Klaus-Kupferschmid/amigahid-pico/kicad/Amiga-HID_rev1.1/Unterseite.stl

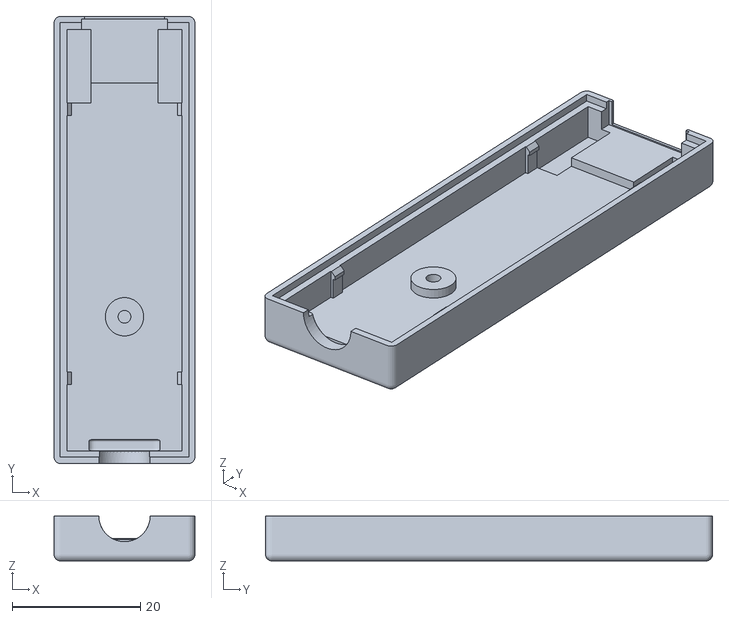
[picture p1: CAD file, 2026-07-23]
kicad/Amiga-HID_rev1.1/Unterseite.stl
22.0 x 69.8 x 7.00
