Klaus-Kupferschmid/amigahid-pico/kicad/Amiga-HID_rev1.1/Oberseite.stl

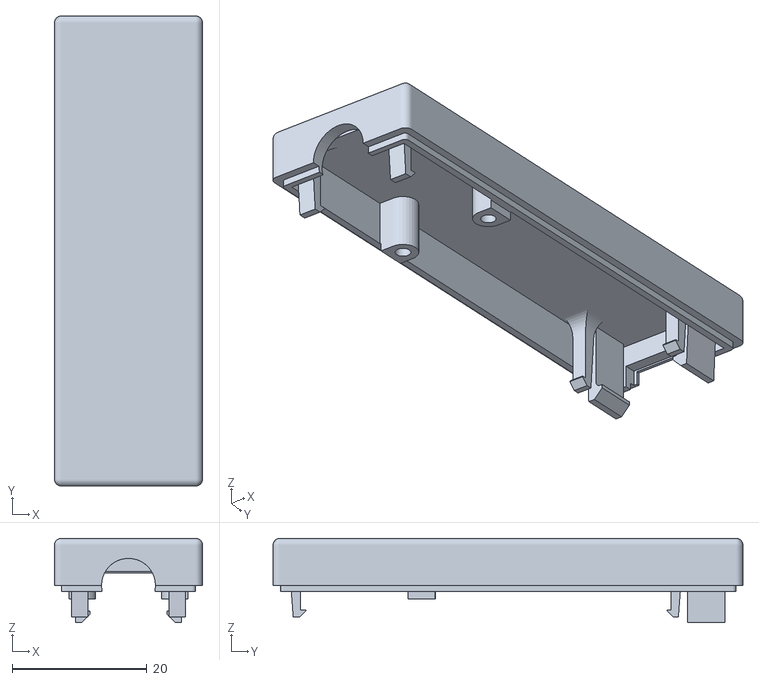
[picture p2: CAD file, 2026-07-23]
kicad/Amiga-HID_rev1.1/Oberseite.stl
22.0 x 69.8 x 12.5
