Klaus-Kupferschmid/amigahid-pico/kicad/Amiga-HID_rev1.1/JST_XH_S5B-XH-A-2_1x05_P2.50mm_Horizontal.step

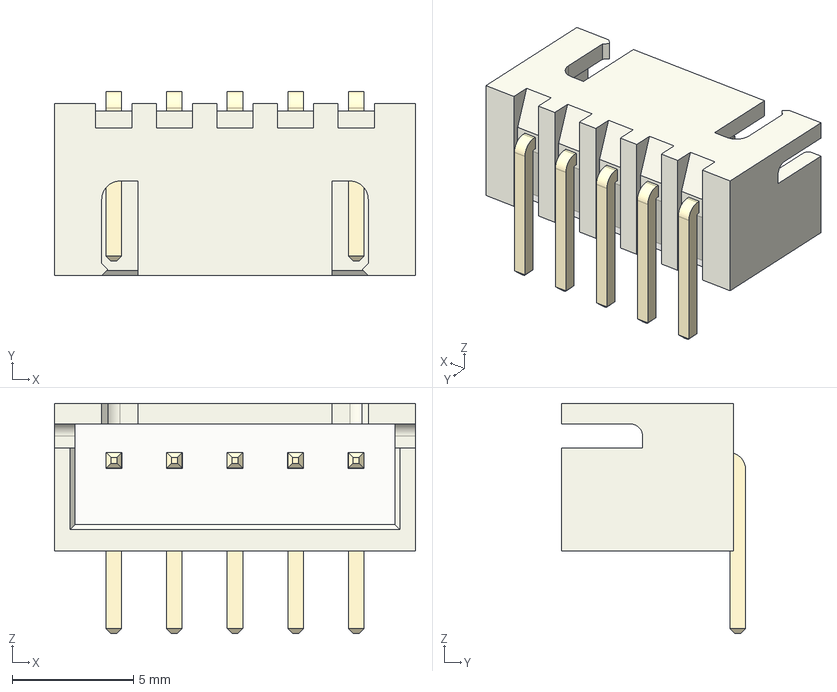
[picture p3: CAD file, 2026-06-02]
kicad/Amiga-HID_rev1.1/JST_XH_S5B-XH-A-2_1x05_P2.50mm_Horizontal.step
14.9 x 7.60 x 9.50 mm
