Klaus-Kupferschmid/amigahid-pico/kicad/Amiga-HID_rev1.1/Amiga-HID_rev1.1.step

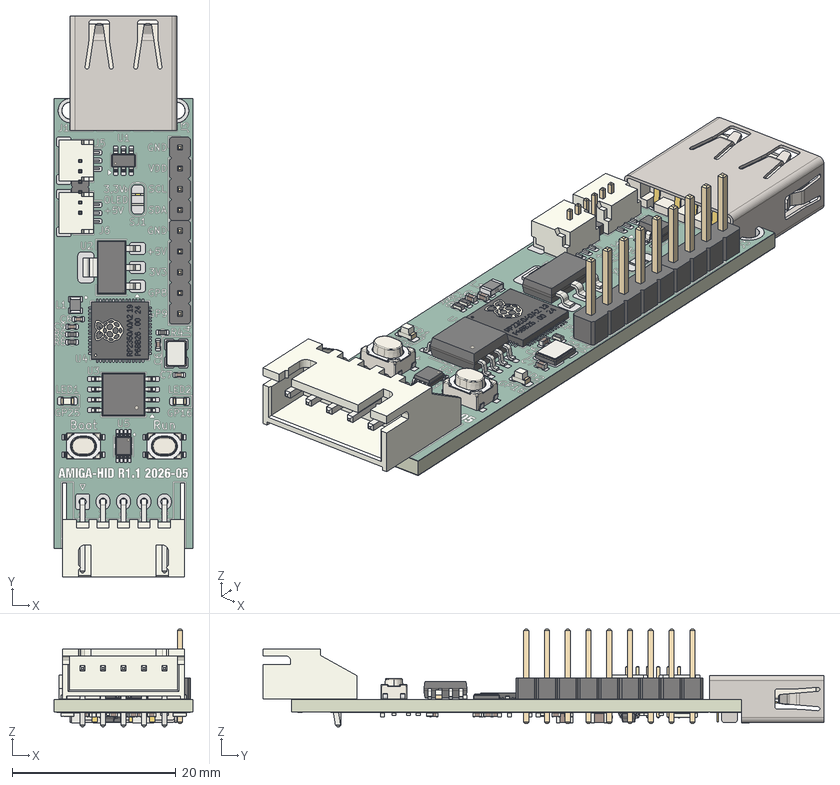
[picture p4: CAD file, 2026-06-02]
kicad/Amiga-HID_rev1.1/Amiga-HID_rev1.1.step
17.0 x 68.6 x 11.9 mm
C139797_TactSwitch_4x3 x 2
PinHeader_1x05_P2.54mm_Vertical
VSSOP-8_2.3x2mm_P0.5mm
C_0402_1005Metric x 21
R_0402_1005Metric x 11
LED_0603_1608Metric x 2
Scale
ShapeString001
ShapeString
SOT-23-6
C1046_Sunlord_L_0805_2u2
SOT-223
JST_SH_SM03B-SRSS-TB_1x03-1MP_P1.00mm_Horizontal x 2
PinHeader_1x06_P1.27mm_Vertical
SOIC-8_5.3x5.3mm_P1.27mm
JST_XH_S5B-XH-A_1x05_P2.50mm_Horizontal
PinHeader_1x04_P2.54mm_Vertical
C42614_USB-A-TH_JTJ
Crystal_SMD_3225-4Pin_3.2x2.5mm
R_0603_1608Metric x 2
D_SOD-323 x 3
C_0805_2012Metric x 2
Fuse_1206_3216Metric
Amiga-HID_rev1.1_copper
Amiga-HID_rev1.1_pad
Amiga-HID_rev1.1_via
Amiga-HID_rev1.1_silkscreen x 2
Amiga-HID_rev1.1_soldermask x 2
Amiga-HID_rev1.1_PCB
