Klaus-Kupferschmid/amigahid-pico/kicad/Amiga-HID_rev1.1/Kabeltülle.stl

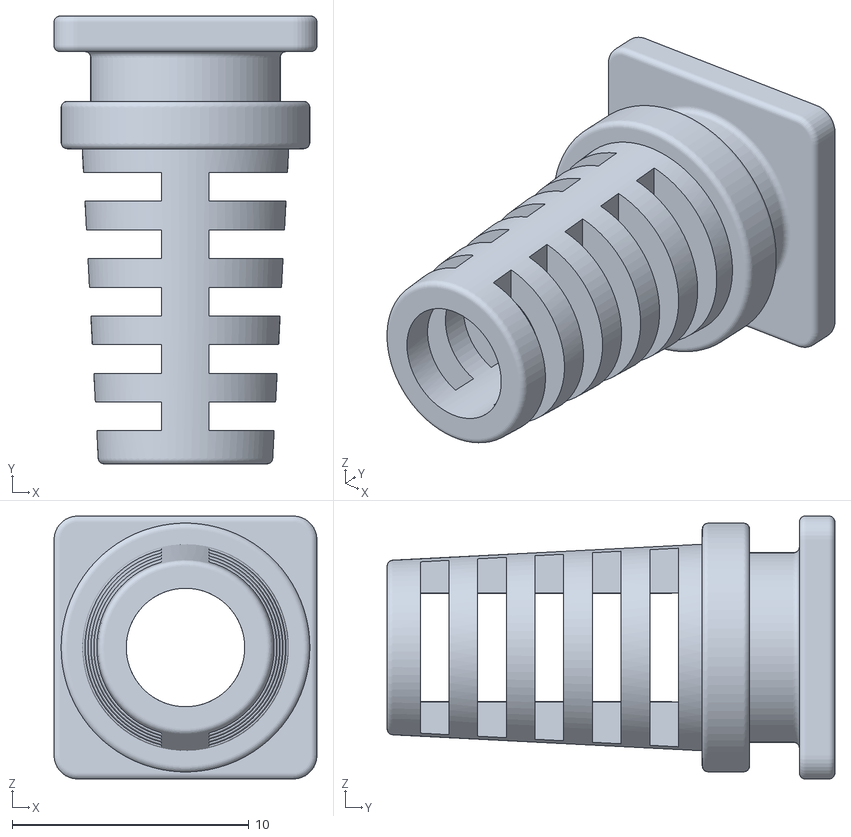
[picture p5: CAD file, 2026-06-02]
kicad/Amiga-HID_rev1.1/Kabeltülle.stl
11.1 x 18.9 x 11.1
