Klaus-Kupferschmid/amigahid-pico/kicad/Amiga-HID_rev1.1/QFN-60_EP3.5_7x7_P0.4mm_RP2350A.step

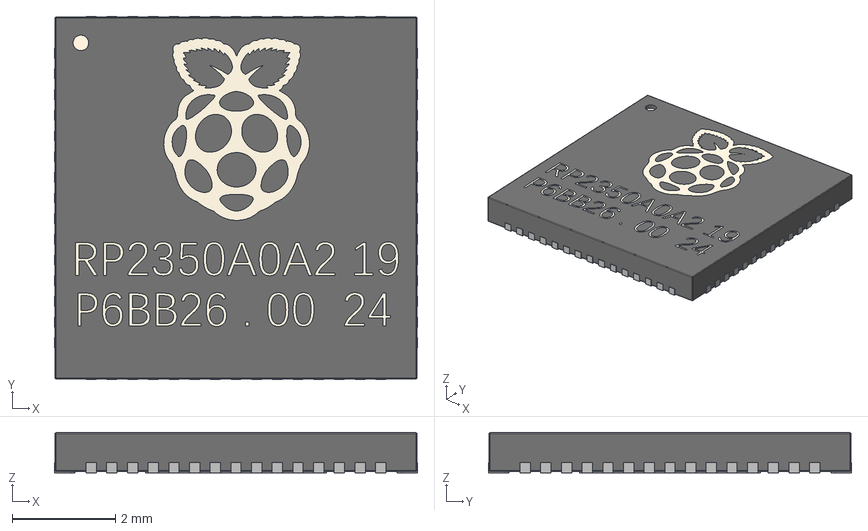
[picture p6: CAD file, 2026-05-04]
kicad/Amiga-HID_rev1.1/QFN-60_EP3.5_7x7_P0.4mm_RP2350A.step
7.02 x 7.02 x 0.785 mm
Scale
ShapeString001
ShapeString
