Klaus-Kupferschmid/amigahid-pico/kicad/Amiga-HID_rev1.1/CONN-SMD_SR1.00-WS-3P.step

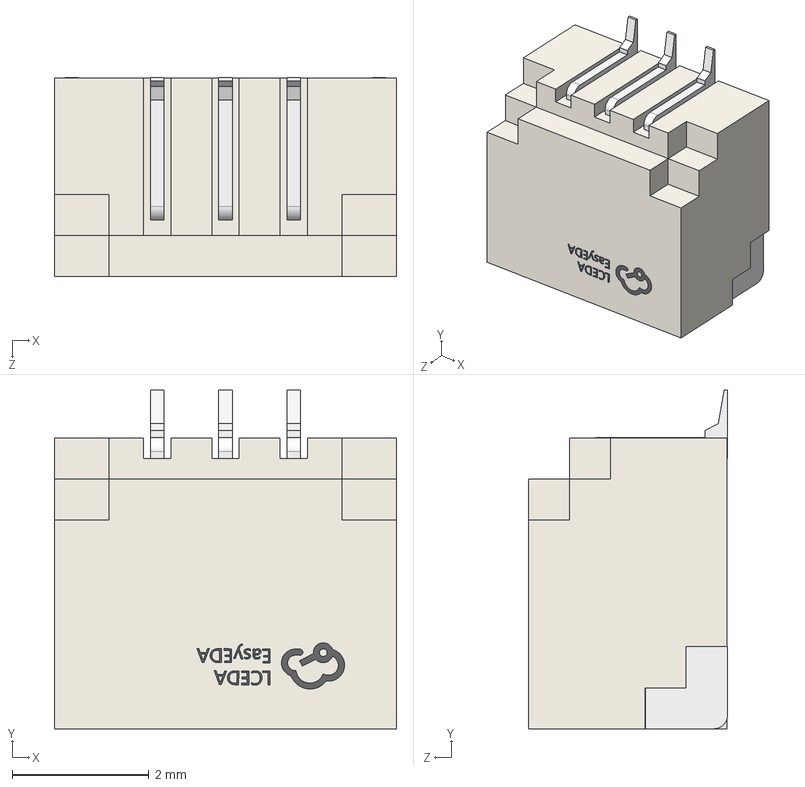
[picture p7: CAD file, 2026-05-03]
kicad/Amiga-HID_rev1.1/CONN-SMD_SR1.00-WS-3P.step
5.00 x 4.95 x 2.91 mm
