Klaus-Kupferschmid/amigahid-pico/kicad/Amiga-HID_rev1.1/C1046_Sunlord_L_0805_2u2.step

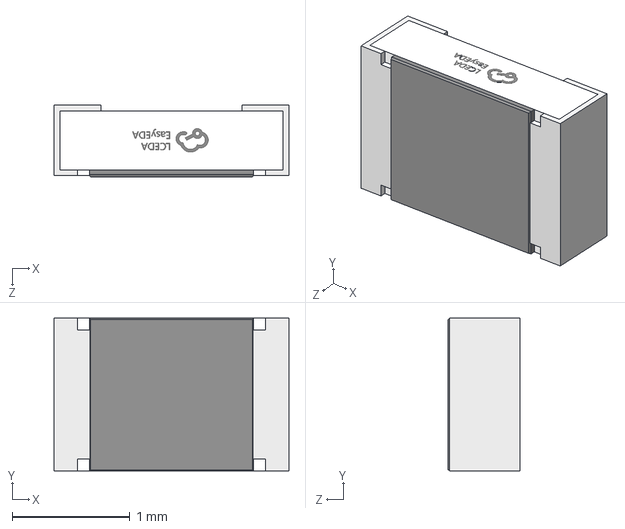
[picture p8: CAD file, 2026-05-03]
kicad/Amiga-HID_rev1.1/C1046_Sunlord_L_0805_2u2.step
2.00 x 1.30 x 0.61 mm
