Klaus-Kupferschmid/amigahid-pico/kicad/Amiga-HID_rev1.1/USB-A-TH_4P-L13.1-W14.1-H5.7-S1.45.step

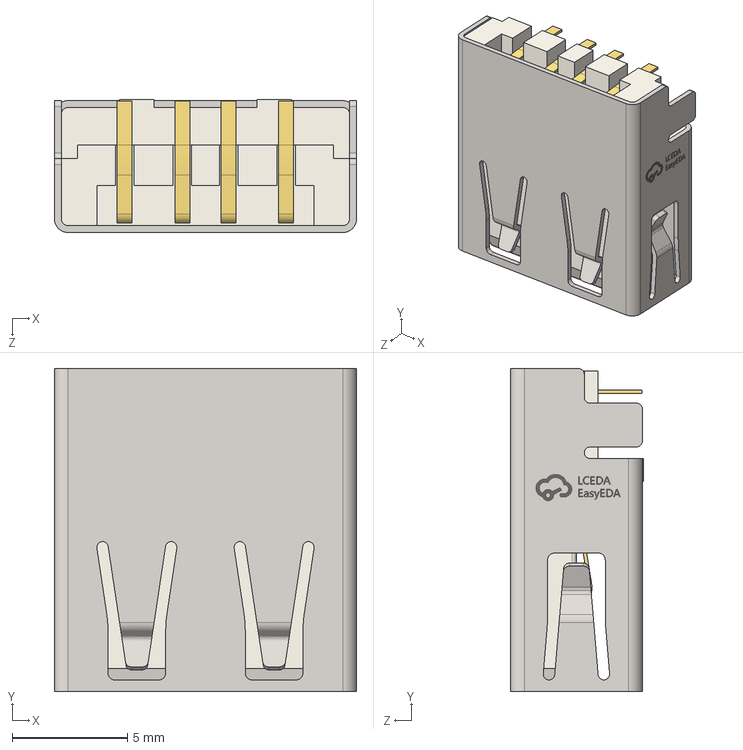
[picture p9: CAD file, 2026-05-03]
kicad/Amiga-HID_rev1.1/USB-A-TH_4P-L13.1-W14.1-H5.7-S1.45.step
13.1 x 14.0 x 5.77 mm
