Klaus-Kupferschmid/amigahid-pico/kicad/Amiga-HID_rev1.1/RP2350_QFN60.step

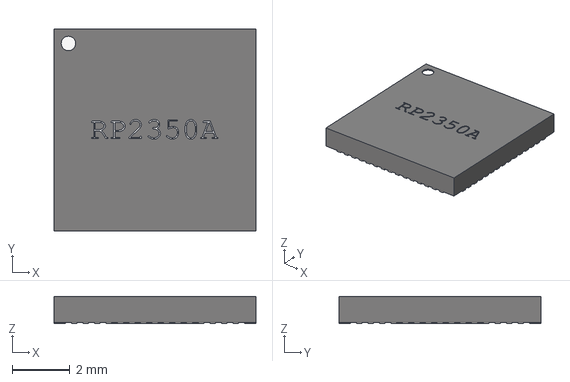
[picture p10: CAD file, 2026-05-02]
kicad/Amiga-HID_rev1.1/RP2350_QFN60.step
7.00 x 7.00 x 0.95 mm
