Klaus-Kupferschmid/amigahid-pico/kicad/Amiga-HID_rev1.1/C139797_TactSwitch_4x3.step

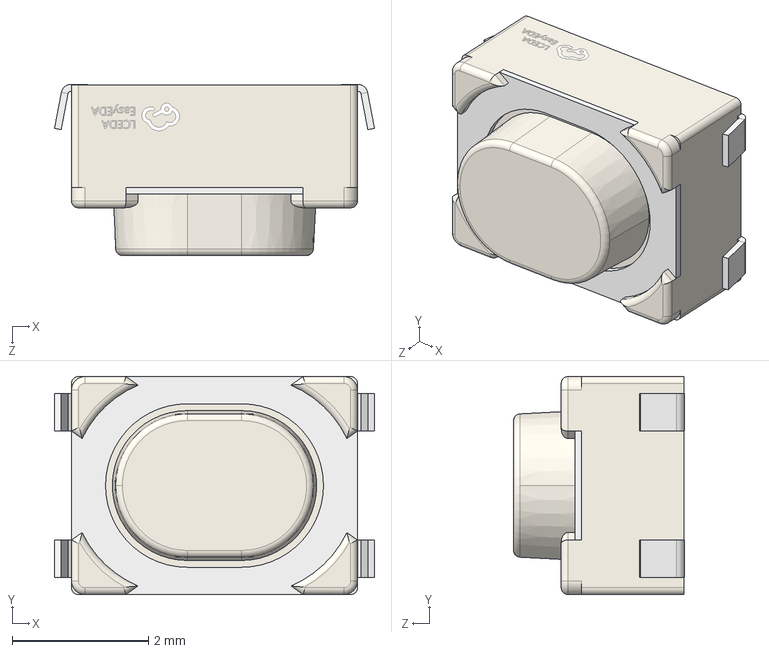
[picture p11: CAD file, 2026-05-03]
kicad/Amiga-HID_rev1.1/C139797_TactSwitch_4x3.step
4.70 x 3.20 x 2.51 mm
