Klaus-Kupferschmid/amigahid-pico/(list of files, cad)

Other CAD files:
kicad/Amiga-HID_rev1.1/JST_XH_S5B-XH-A-1_1x05_P2.50mm_Horizontal.stl
kicad/Amiga-HID_rev1.1/S5B-XH-A.stl
