Klaus-Kupferschmid/amigahid-pico/kicad/Amiga-HID_rev1.1/USB_A_Receptacle_Edge_C42614.pdf

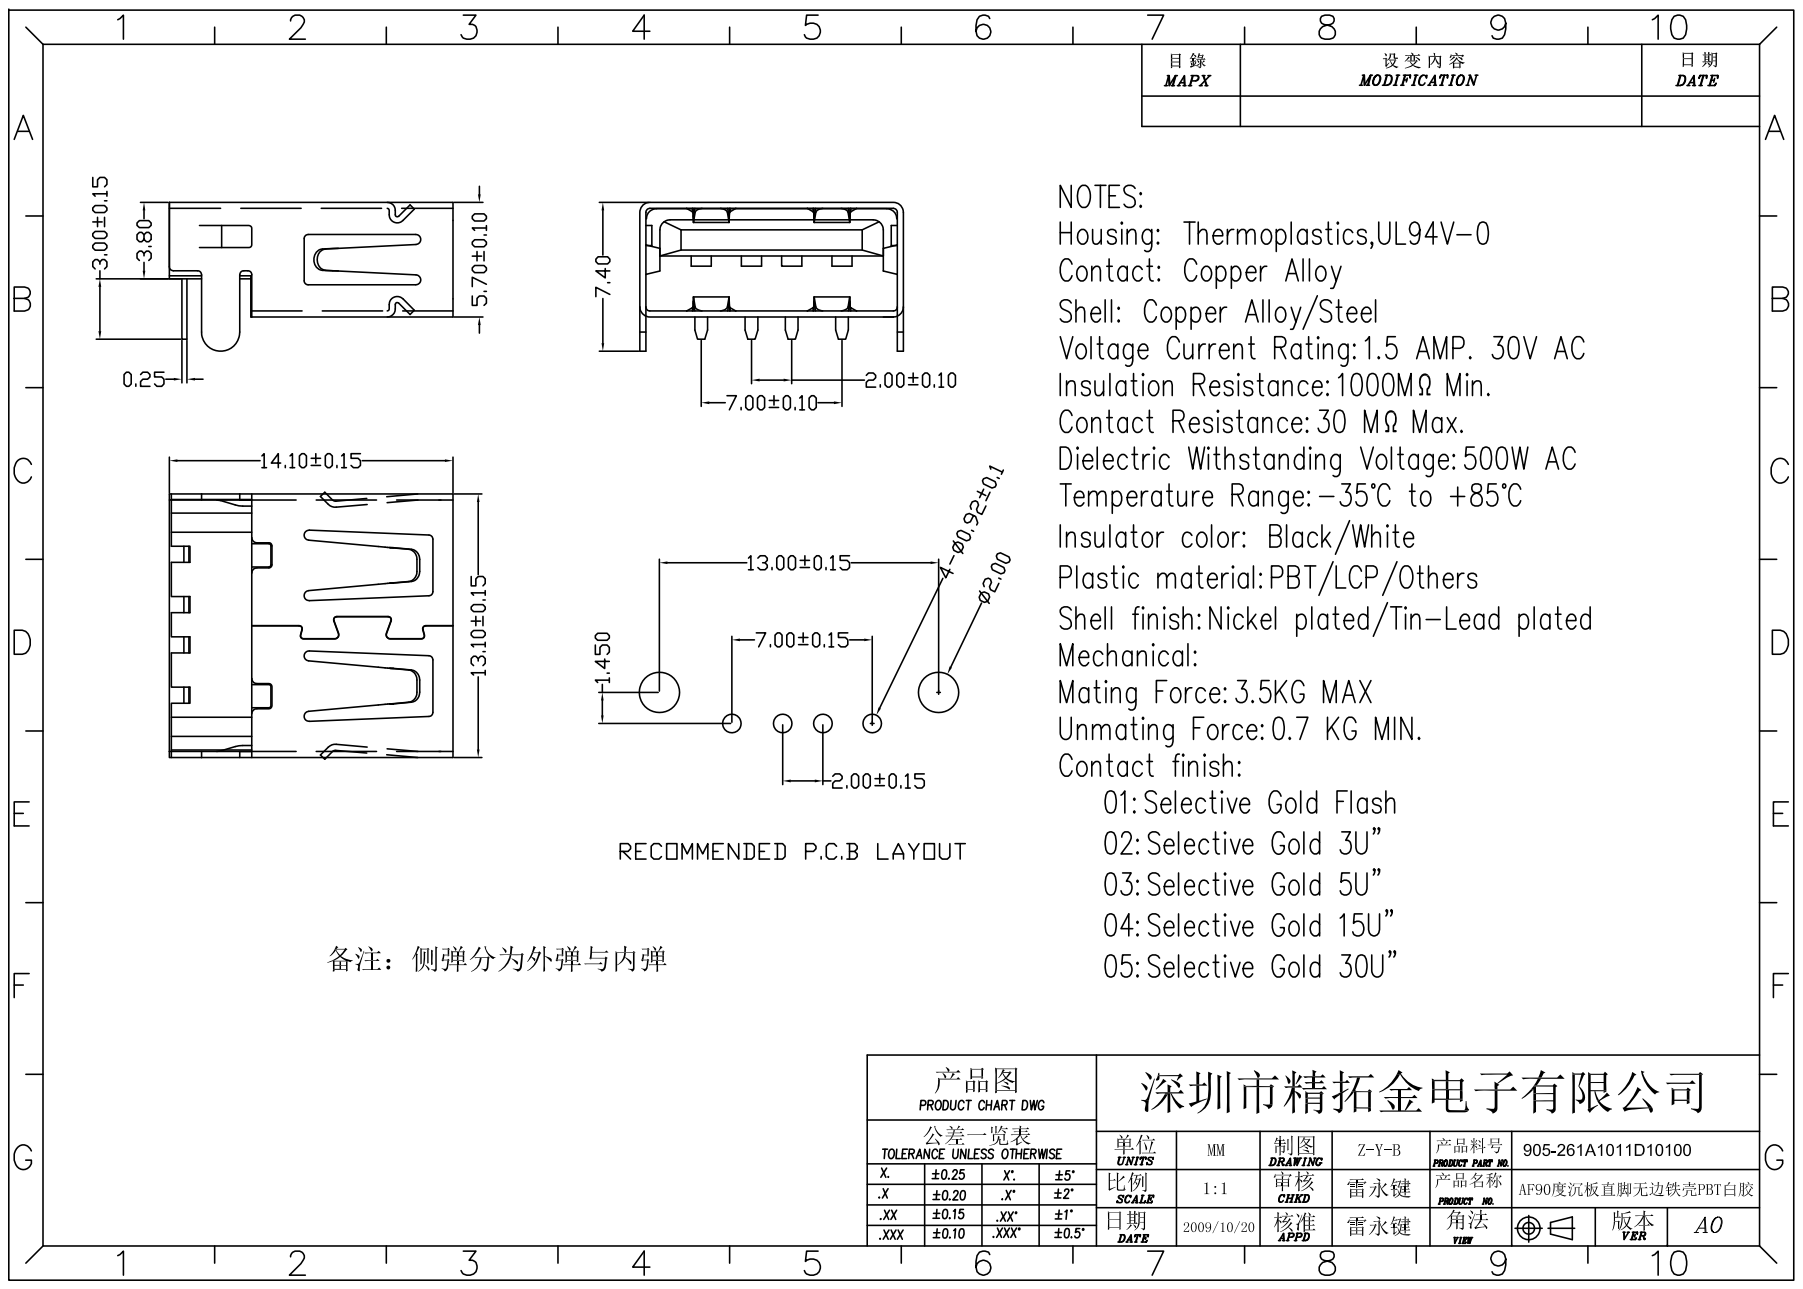
[picture p12: page 1]
