Klaus-Kupferschmid/amigahid-pico/kicad/Amiga-HID_rev1.1/Amiga-HID_rev1.1.kicad_pcb

## KiCad design kicad/Amiga-HID_rev1.1/Amiga-HID_rev1.1.kicad_pcb (2026-07-02)

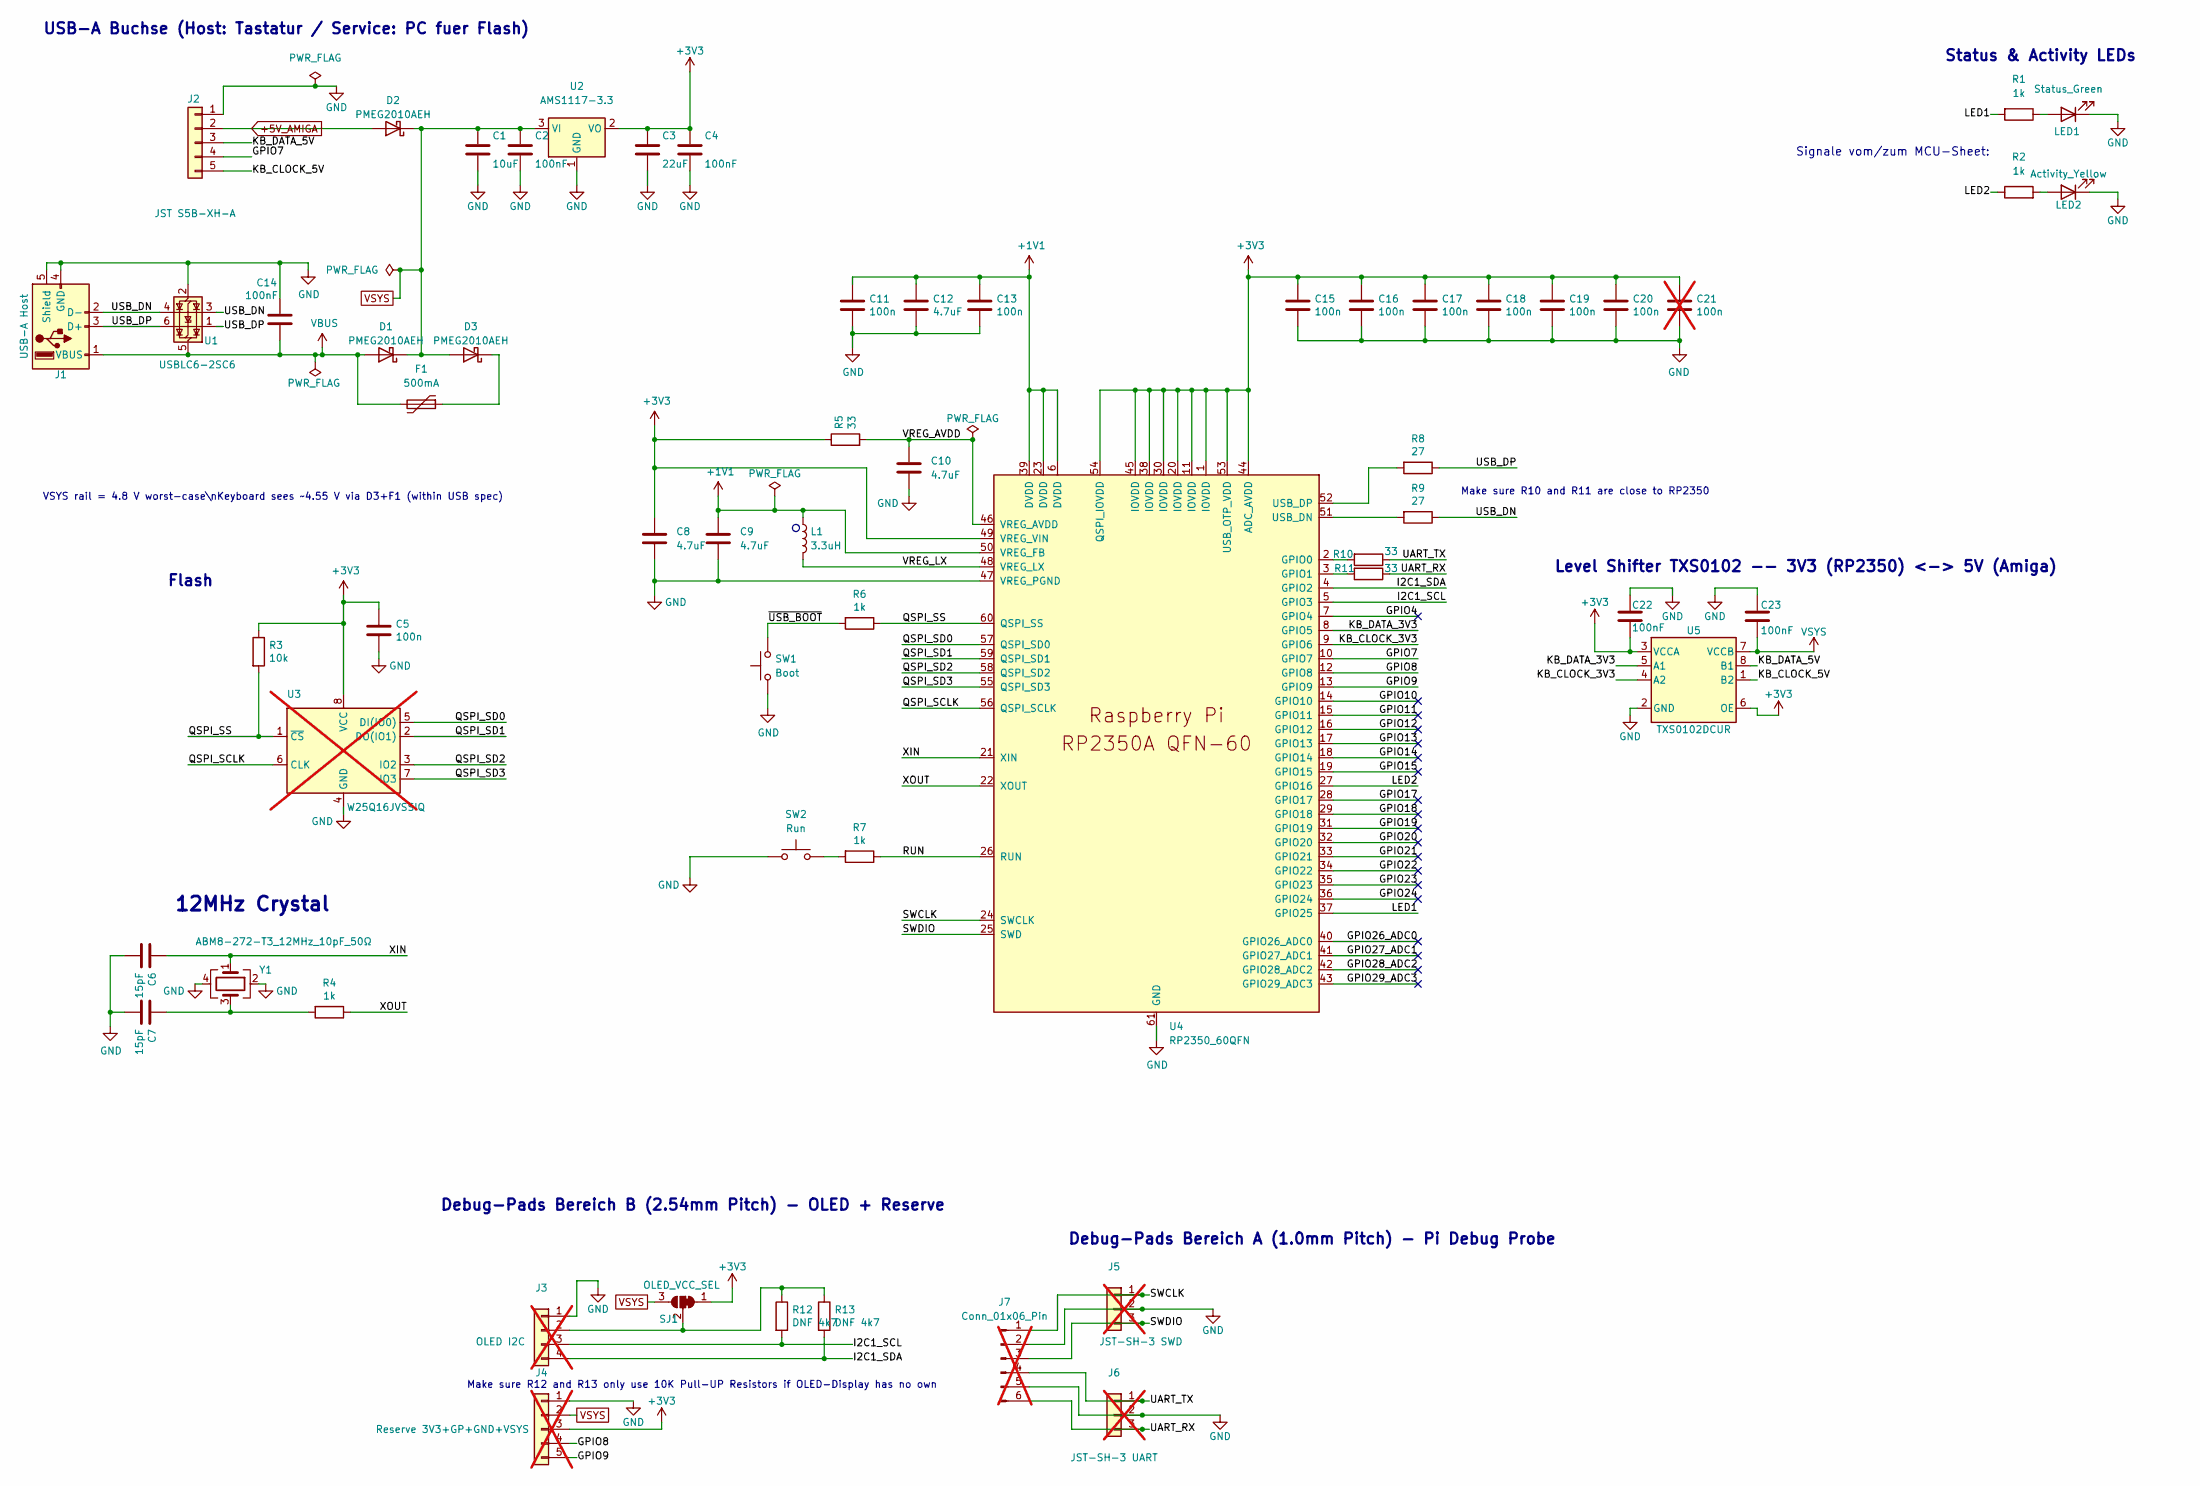
[picture p13: schematic Amiga-HID_rev1.1.kicad_sch, Amiga-HID rev1.1]

Parts:
C1: 10uF; C_0805_2012Metric; LCSC C15850
C2, C14, C22, C23: 100nF; C_0402_1005Metric; LCSC C161530
C3: 22uF; C_0805_2012Metric; LCSC C45783
C4: 100nF; C_0402_1005Metric; LCSC C1525
C5: 100n; C_0402_1005Metric; LCSC C1525
C6, C7: 15pF; C_0402_1005Metric; LCSC C18164617
C8, C9, C10, C12: 4.7uF; C_0402_1005Metric; LCSC C368809
C11, C13, C15, C16, C17, C18, C19, C20: 100n; C_0402_1005Metric; LCSC C161530
C21: 100n; C_0402_1005Metric; LCSC C161530; not fitted
D1, D2, D3: PMEG2010AEH; D_SOD-323; LCSC C53114226
F1: 500mA; Fuse_1206_3216Metric; LCSC C7202014
J1: USB-A Host; USB_A_Receptacle_Edge_C42614; LCSC C42614
J2: JST S5B-XH-A; S5B-XH-A; LCSC C42422447
J3: OLED I2C; PinHeader_1x04_P2.54mm_Vertical; LCSC C52016392; not fitted
J4: Reserve 3V3+GP+GND+VSYS; PinHeader_1x05_P2.54mm_Vertical; LCSC C225480; not fitted
J5: JST-SH-3 SWD; JST_SH_SM03B-SRSS-TB_1x03-1MP_P1.00mm_Horizontal; LCSC C160403; not fitted
J6: JST-SH-3 UART; JST_SH_SM03B-SRSS-TB_1x03-1MP_P1.00mm_Horizontal; LCSC C160403; not fitted
J7: Conn_01x06_Pin; PinHeader_1x06_P1.27mm_Vertical; LCSC C5372829; not fitted
L1: 3.3uH; L_pol_2016; MPN MWSA201610H2R2MT; LCSC C42411119
LED1: Status_Green; LED_0603_1608Metric; LCSC C965804
LED2: Activity_Yellow; LED_0603_1608Metric; LCSC C72038
R1, R2: 1k; R_0603_1608Metric; LCSC C21190
R3: 10k; R_0402_1005Metric; LCSC C25744
R4, R6, R7: 1k; R_0402_1005Metric; LCSC C11702
R5, R10, R11: 33; R_0402_1005Metric; LCSC C25105
R8, R9: 27; R_0402_1005Metric; LCSC C25100
R12, R13: DNF 4k7; R_0402_1005Metric; LCSC C25900
SJ1: OLED_VCC_SEL; SolderJumper-3_P1.3mm_Bridged12_RoundedPad1.0x1.5mm
SW1: Boot; SW_Push_1P1T_NO_Vertical_Wuerth_434133025816; LCSC C139797
SW2: Run; SW_Push_1P1T_NO_Vertical_Wuerth_434133025816; LCSC C139797
U1: USBLC6-2SC6; SOT-23-6; LCSC C19170930
U2: AMS1117-3.3; SOT-223-3_TabPin2; LCSC C2688239
U3: W25Q16JVSSIQ; SOIC-8_5.3x5.3mm_P1.27mm; LCSC C82317; not fitted
U4: RP2350_60QFN; RP2350-QFN-60-1EP_7x7_P0.4mm_EP3.4x3.4mm_ThermalVias; LCSC C41378174
U5: TXS0102DCUR; VSSOP-8_2.3x2mm_P0.5mm; LCSC C53434
Y1: ABM8-272-T3_12MHz_10pF_50Ω; Crystal_SMD_3225-4Pin_3.2x2.5mm; LCSC C20625731

Connections:
+1V1: C9.1, C11.1, C12.1, C13.1, L1.1, U4.6 (DVDD), U4.23 (DVDD), U4.39 (DVDD), U4.50 (VREG_FB)
+3V3: C3.1, C4.1, C5.1, C8.1, C15.1, C16.1, C17.1, C18.1, C19.1, C20.1, C21.1, C22.2, J4.3, R3.1, R5.1, SJ1.1 (A), U2.2 (VO), U3.8 (VCC), U4.1 (IOVDD), U4.11 (IOVDD), U4.20 (IOVDD), U4.30 (IOVDD), U4.38 (IOVDD), U4.44 (ADC_AVDD), U4.45 (IOVDD), U4.49 (VREG_VIN), U4.53 (USB_OTP_VDD), U4.54 (QSPI_IOVDD), U5.3 (VCCA), U5.6 (OE)
+5V_AMIGA: D2.2 (A), J2.2
/GPIO4: U4.7 (GPIO4)
/GPIO7: J2.4, U4.10 (GPIO7)
/GPIO8: J4.4, U4.12 (GPIO8)
/GPIO9: J4.5, U4.13 (GPIO9)
/GPIO10: U4.14 (GPIO10)
/GPIO11: U4.15 (GPIO11)
/GPIO12: U4.16 (GPIO12)
/GPIO13: U4.17 (GPIO13)
/GPIO14: U4.18 (GPIO14)
/GPIO15: U4.19 (GPIO15)
/GPIO17: U4.28 (GPIO17)
/GPIO18: U4.29 (GPIO18)
/GPIO19: U4.31 (GPIO19)
/GPIO20: U4.32 (GPIO20)
/GPIO21: U4.33 (GPIO21)
/GPIO22: U4.34 (GPIO22)
/GPIO23: U4.35 (GPIO23)
/GPIO24: U4.36 (GPIO24)
/GPIO26_ADC0: U4.40 (GPIO26_ADC0)
/GPIO27_ADC1: U4.41 (GPIO27_ADC1)
/GPIO28_ADC2: U4.42 (GPIO28_ADC2)
/GPIO29_ADC3: U4.43 (GPIO29_ADC3)
/I2C1_SCL: J3.3, R12.2, U4.5 (GPIO3)
/I2C1_SDA: J3.4, R13.2, U4.4 (GPIO2)
/KB_CLOCK_3V3: U4.9 (GPIO6), U5.4 (A2)
/KB_CLOCK_5V: J2.5, U5.1 (B2)
/KB_DATA_3V3: U4.8 (GPIO5), U5.5 (A1)
/KB_DATA_5V: J2.3, U5.8 (B1)
/LED1: R1.2, U4.37 (GPIO25)
/LED2: R2.1, U4.27 (GPIO16)
/QSPI_SCLK: U3.6 (CLK), U4.56 (QSPI_SCLK)
/QSPI_SD0: U3.5 (DI(IO0)), U4.57 (QSPI_SD0)
/QSPI_SD1: U3.2 (DO(IO1)), U4.59 (QSPI_SD1)
/QSPI_SD2: U3.3 (IO2), U4.58 (QSPI_SD2)
/QSPI_SD3: U3.7 (IO3), U4.55 (QSPI_SD3)
/QSPI_SS: R3.2, R6.1, U3.1 (~CS), U4.60 (QSPI_SS)
/RUN: R7.1, U4.26 (RUN)
/SWCLK: J5.1, J7.1, U4.24 (SWCLK)
/SWDIO: J5.3, J7.3, U4.25 (SWD)
/UART_RX: J6.3, J7.6, R11.1
/UART_TX: J6.1, J7.4, R10.1
/USB_DN: J1.2 (D-), R9.1, U1.3 (I/O2), U1.4 (I/O2)
/USB_DP: J1.3 (D+), R8.1, U1.1 (I/O1), U1.6 (I/O1)
/VREG_AVDD: C10.1, R5.2, U4.46 (VREG_AVDD)
/VREG_LX: L1.2, U4.48 (VREG_LX)
/XIN: C6.1, U4.21 (XIN), Y1.1
/XOUT: R4.1, U4.22 (XOUT)
/~USB_BOOT: R6.2, SW1.2
GND: C1.2, C2.2, C3.2, C4.2, C5.2, C6.2, C7.2, C8.2, C9.2, C10.2, C11.2, C12.2, C13.2, C14.1, C15.2, C16.2, C17.2, C18.2, C19.2, C20.2, C21.2, C22.1, C23.1, J1.4 (GND), J1.5 (Shield), J2.1, J3.1, J4.1, J5.2, J6.2, J7.2, J7.5, LED1.1 (K), LED2.1 (K), SW1.1, SW2.1, U1.2 (GND), U2.1 (GND), U3.4 (GND), U4.47 (VREG_PGND), U4.61 (GND), U5.2 (GND), Y1.2, Y1.4
unnamed: C7.1, R4.2, Y1.3
unnamed: D3.1 (K), F1.1
unnamed: J3.2, R12.1, R13.1, SJ1.2 (C)
unnamed: LED1.2 (A), R1.1
unnamed: LED2.2 (A), R2.2
unnamed: R7.2, SW2.2
unnamed: R10.2, U4.2 (GPIO0)
unnamed: R11.2, U4.3 (GPIO1)
unnamed: R9.2, U4.51 (USB_DN)
unnamed: R8.2, U4.52 (USB_DP)
VBUS: C14.2, D1.2 (A), F1.2, J1.1 (VBUS), U1.5 (VBUS)
VSYS: C1.1, C2.1, C23.2, D1.1 (K), D2.1 (K), D3.2 (A), J4.2, SJ1.3 (B), U2.3 (VI), U5.7 (VCCB)

Notes on the sheet:
USB-A Buchse (Host: Tastatur / Service: PC fuer Flash)
Make sure R12 and R13 only use 10K Pull-UP Resistors if OLED-Display has no own
Signale vom/zum MCU-Sheet:
Status & Activity LEDs
Flash
Debug-Pads Bereich B (2.54mm Pitch) - OLED + Reserve
Make sure R10 and R11 are close to RP2350
Level Shifter TXS0102 -- 3V3 (RP2350) <-> 5V (Amiga)
12MHz Crystal
VSYS rail = 4.8 V worst-case\nKeyboard sees ~4.55 V via D3+F1 (within USB spec)
Debug-Pads Bereich A (1.0mm Pitch) - Pi Debug Probe

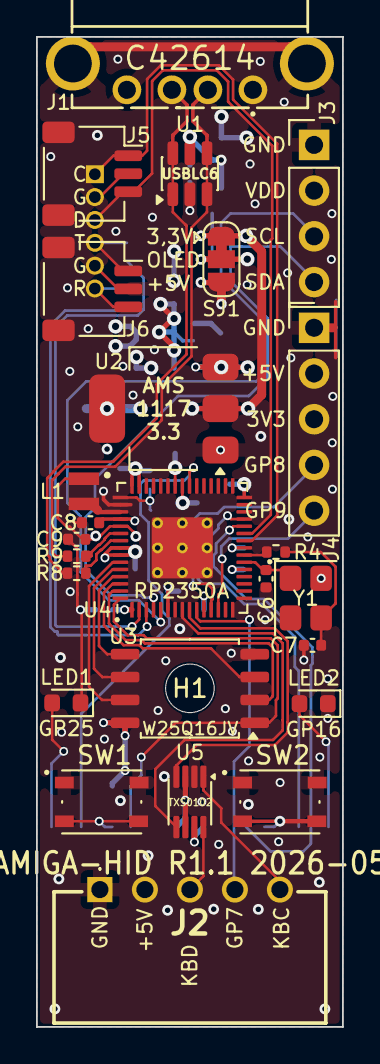
[picture p14: board Amiga-HID_rev1.1.kicad_pcb from above]

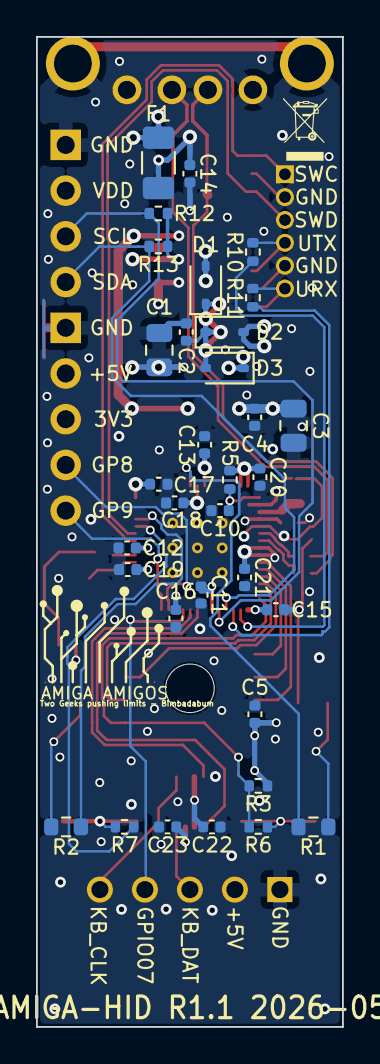
[picture p15: board Amiga-HID_rev1.1.kicad_pcb from below]

Board: 4 copper layers, 17.0 x 55.0 mm, 60 parts (33 on the bottom side), 45 nets.

Other parts of the board:
H1: MountingHole; MountingHole_2.7mm
