Klaus-Kupferschmid/amigahid-pico/kicad/amigahid-pico/amigahid-pico.kicad_pcb

## KiCad design kicad/amigahid-pico/amigahid-pico.kicad_pcb (2026-05-06)

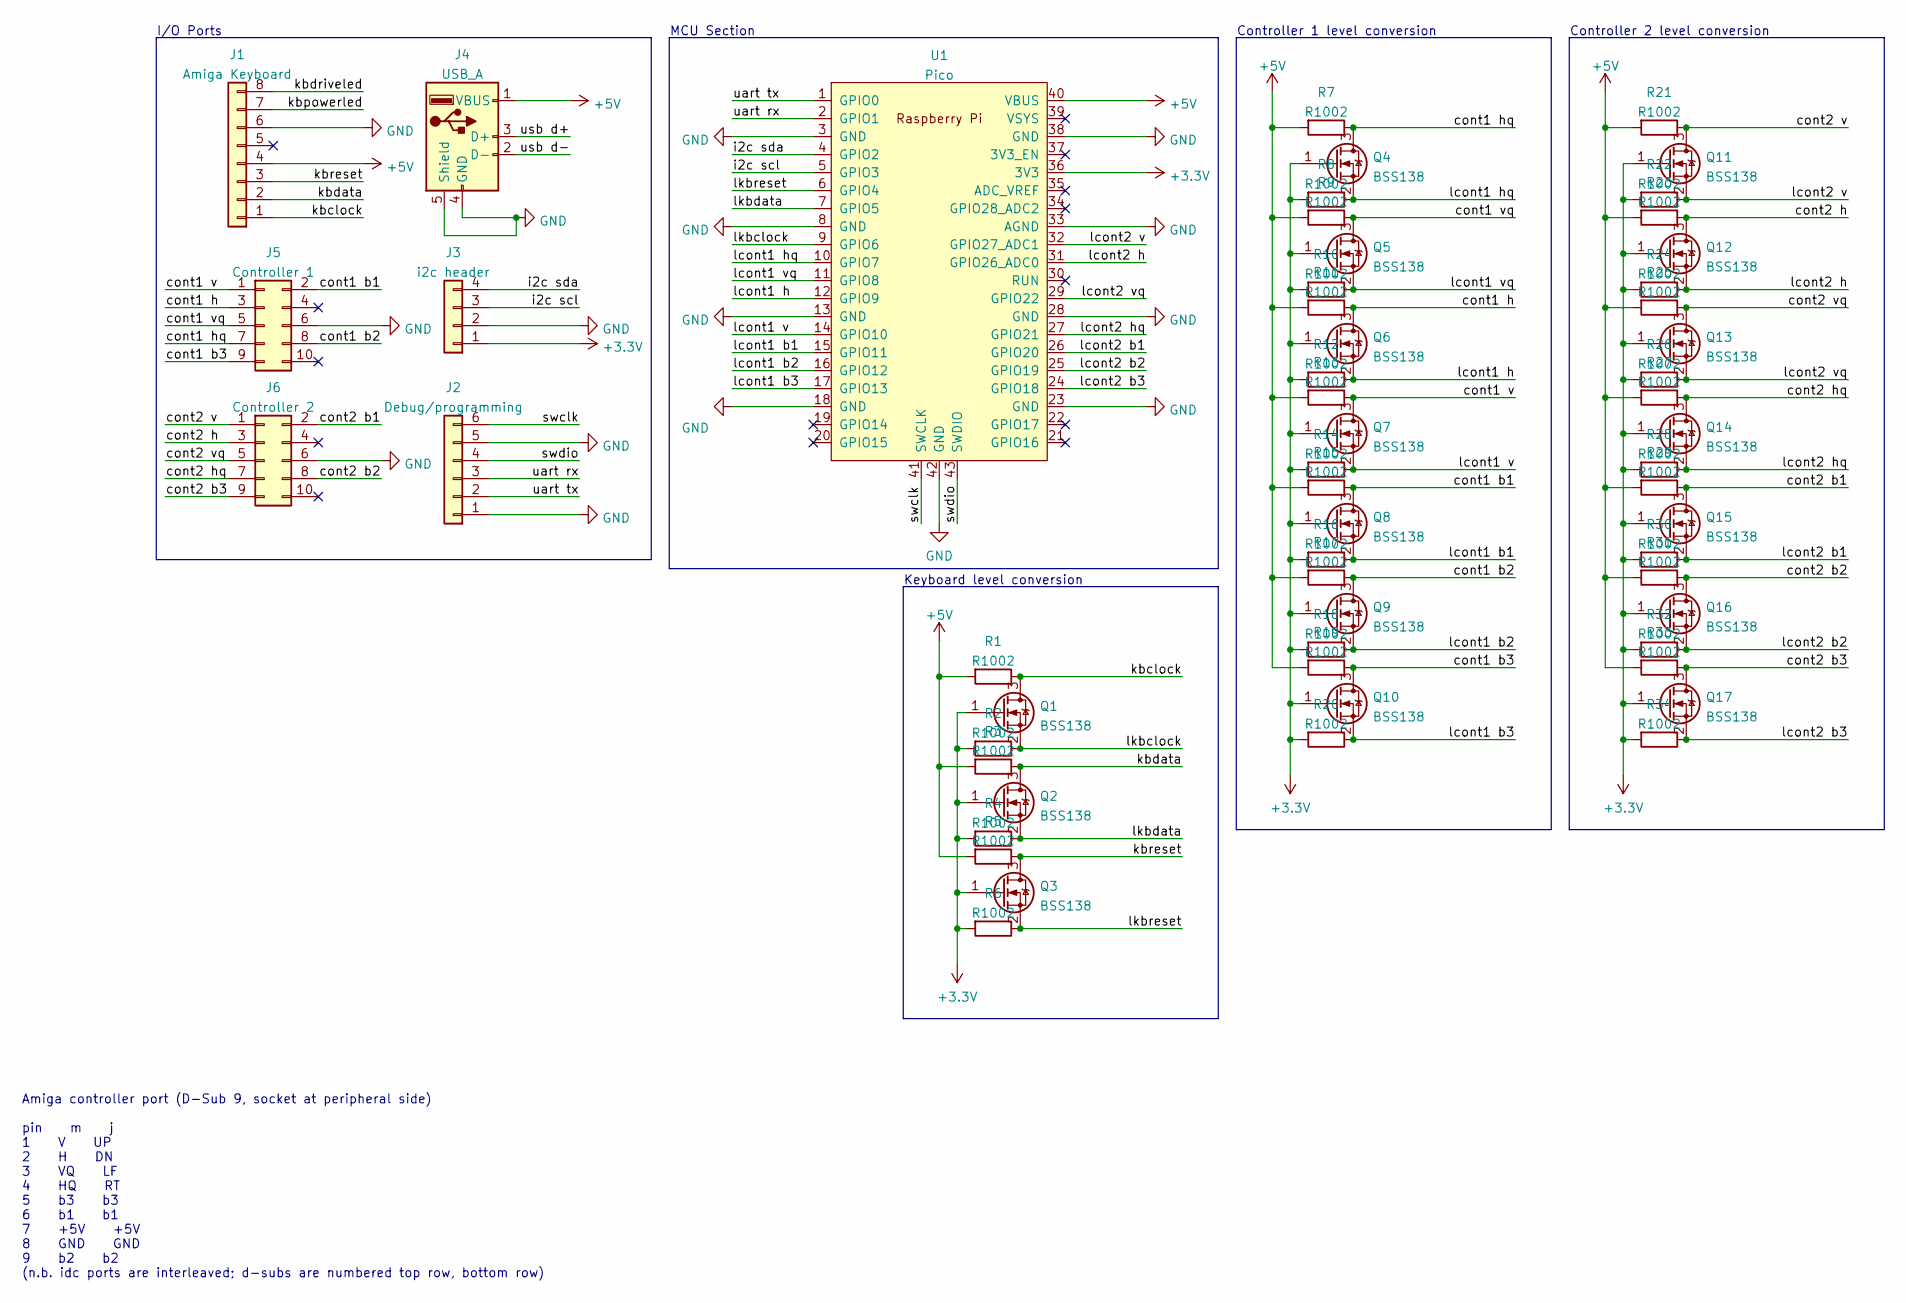
[picture p18: schematic amigahid-pico.kicad_sch, amiga keyboard adapter]

Parts:
J1: Amiga Keyboard; PinHeader_1x08_P2.54mm_Vertical
J2: Debug/programming; PinHeader_1x06_P2.54mm_Horizontal
J3: i2c header; PinHeader_1x04_P2.54mm_Vertical
J4: USB_A; USB_A_Molex_67643_Horizontal
J5: Controller 1; IDC-Header_2x05_P2.54mm_Vertical
J6: Controller 2; IDC-Header_2x05_P2.54mm_Vertical
Q1, Q2, Q3, Q4, Q5, Q6, Q7, Q8, Q9, Q10, Q11, Q12, Q13, Q14, Q15, Q16, Q17: BSS138; SOT-23
R1, R2, R3, R4, R5, R6, R7, R8, R9, R10, R11, R12, R13, R14, R15, R16, R17, R18, R19, R20, R21, R22, R23, R24, R25, R26, R27, R28, R29, R30, R31, R32, R33, R34: R1002; R_0603_1608Metric
U1: Pico; RPi_Pico_SMD_TH

Connections:
+3V3: J3.1, Q1.1 (G), Q2.1 (G), Q3.1 (G), Q4.1 (G), Q5.1 (G), Q6.1 (G), Q7.1 (G), Q8.1 (G), Q9.1 (G), Q10.1 (G), Q11.1 (G), Q12.1 (G), Q13.1 (G), Q14.1 (G), Q15.1 (G), Q16.1 (G), Q17.1 (G), R2.2, R4.2, R6.2, R8.2, R10.2, R12.2, R14.2, R16.2, R18.2, R20.2, R22.2, R24.2, R26.2, R28.2, R30.2, R32.2, R34.2, U1.36 (3V3)
+5V: J1.4, J4.1 (VBUS), R1.2, R3.2, R5.2, R7.2, R9.2, R11.2, R13.2, R15.2, R17.2, R19.2, R21.2, R23.2, R25.2, R27.2, R29.2, R31.2, R33.2, U1.40 (VBUS); also elsewhere on the board
/cont1 b1: J5.2, Q8.3 (D), R15.1; also elsewhere on the board
/cont1 b2: J5.8, Q9.3 (D), R17.1
/cont1 b3: J5.9, Q10.3 (D), R19.1
/cont1 h: J5.3, Q6.3 (D), R11.1
/cont1 hq: J5.7, Q4.3 (D), R7.1
/cont1 v: J5.1, Q7.3 (D), R13.1
/cont1 vq: J5.5, Q5.3 (D), R9.1
/cont2 b1: J6.2, Q15.3 (D), R29.1
/cont2 b2: J6.8, Q16.3 (D), R31.1
/cont2 b3: J6.9, Q17.3 (D), R33.1
/cont2 h: J6.3, Q12.3 (D), R23.1
/cont2 hq: J6.7, Q14.3 (D), R27.1
/cont2 v: J6.1, Q11.3 (D), R21.1
/cont2 vq: J6.5, Q13.3 (D), R25.1
/i2c scl: J3.3, U1.5 (GPIO3)
/i2c sda: J3.4, U1.4 (GPIO2)
/kbclock: J1.1, Q1.3 (D), R1.1
/kbdata: J1.2, Q2.3 (D), R3.1
/kbdriveled: J1.8
/kbpowerled: J1.7
/kbreset: J1.3, Q3.3 (D), R5.1
/lcont1 b1: Q8.2 (S), R16.1, U1.15 (GPIO11)
/lcont1 b2: Q9.2 (S), R18.1, U1.16 (GPIO12)
/lcont1 b3: Q10.2 (S), R20.1, U1.17 (GPIO13)
/lcont1 h: Q6.2 (S), R12.1, U1.12 (GPIO9)
/lcont1 hq: Q4.2 (S), R8.1, U1.10 (GPIO7)
/lcont1 v: Q7.2 (S), R14.1, U1.14 (GPIO10)
/lcont1 vq: Q5.2 (S), R10.1, U1.11 (GPIO8)
/lcont2 b1: Q15.2 (S), R30.1, U1.26 (GPIO20)
/lcont2 b2: Q16.2 (S), R32.1, U1.25 (GPIO19)
/lcont2 b3: Q17.2 (S), R34.1, U1.24 (GPIO18)
/lcont2 h: Q12.2 (S), R24.1, U1.31 (GPIO26_ADC0)
/lcont2 hq: Q14.2 (S), R28.1, U1.27 (GPIO21)
/lcont2 v: Q11.2 (S), R22.1, U1.32 (GPIO27_ADC1)
/lcont2 vq: Q13.2 (S), R26.1, U1.29 (GPIO22)
/lkbclock: Q1.2 (S), R2.1, U1.9 (GPIO6)
/lkbdata: Q2.2 (S), R4.1, U1.7 (GPIO5)
/lkbreset: Q3.2 (S), R6.1, U1.6 (GPIO4)
/swclk: J2.6, U1.41 (SWCLK)
/swdio: J2.4, U1.43 (SWDIO)
/uart rx: J2.3, U1.2 (GPIO1)
/uart tx: J2.2, U1.1 (GPIO0)
/usb d+: J4.3 (D+)
/usb d-: J4.2 (D-)
GND: J1.6, J2.1, J2.5, J3.2, J4.4 (GND), J4.5 (Shield), J5.6, J6.6, U1.3 (GND), U1.8 (GND), U1.13 (GND), U1.18 (GND), U1.23 (GND), U1.28 (GND), U1.33 (AGND), U1.38 (GND), U1.42 (GND)

Notes on the sheet:
Amiga controller port (D-Sub 9, socket at peripheral side) pin m j 1 V UP 2 H DN 3 VQ LF 4 HQ RT 5 b3 b3 6 b1 b1 7 +5V +5V 8 GND GND 9 b2 b2 (n.b. idc ports are interleaved; d-subs are numbered top row, bottom row)
MCU Section
I/O Ports
Controller 1 level conversion
Controller 2 level conversion
Keyboard level conversion

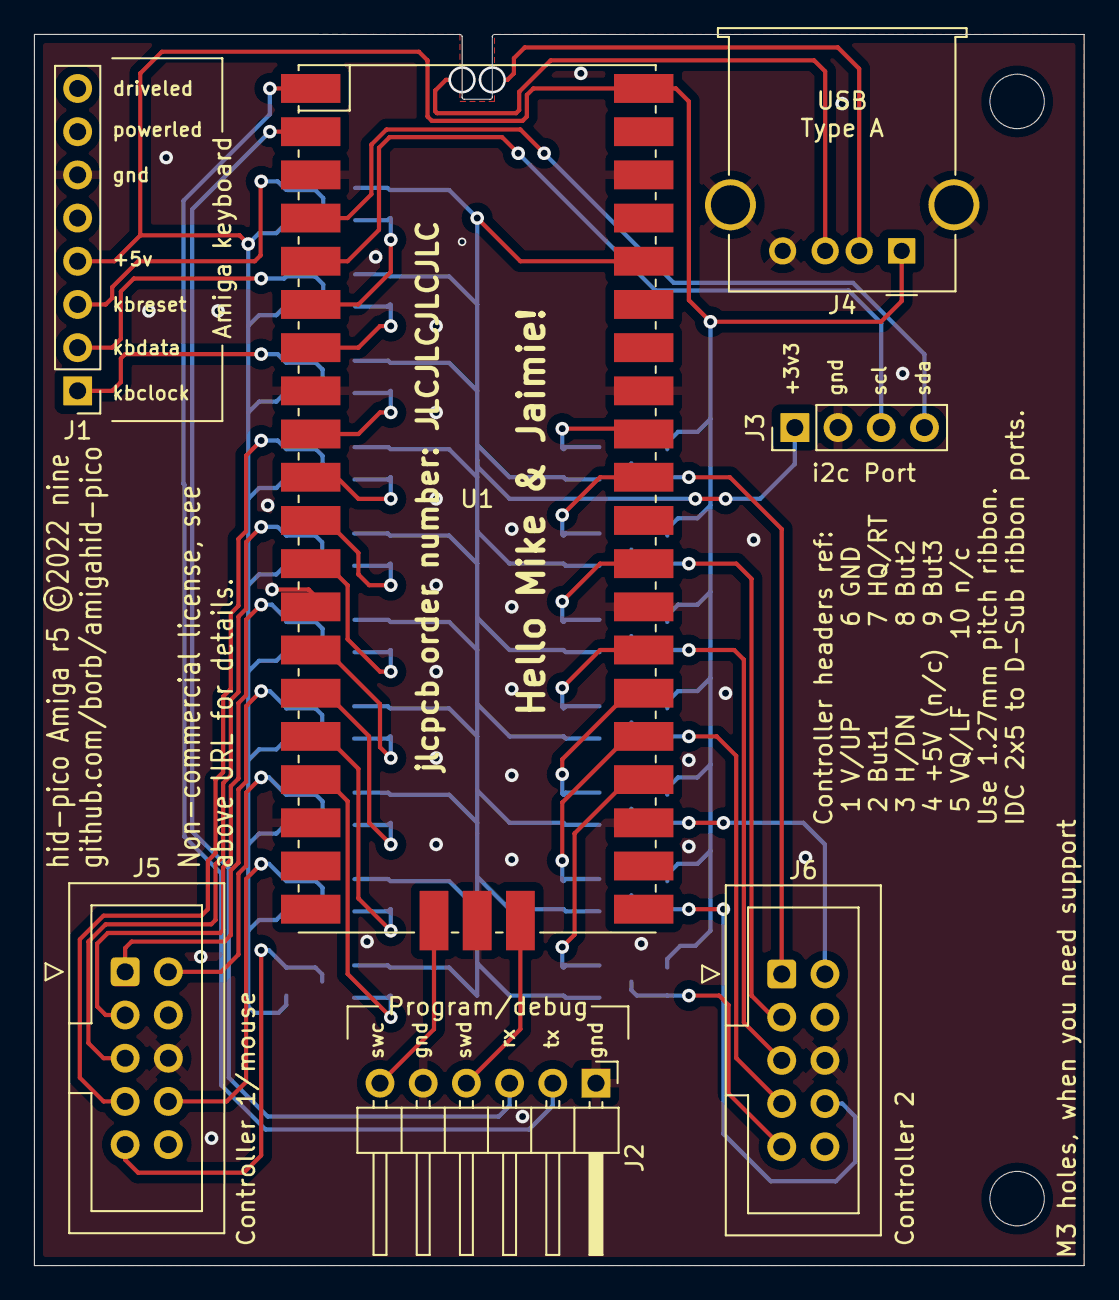
[picture p19: board amigahid-pico.kicad_pcb from above]

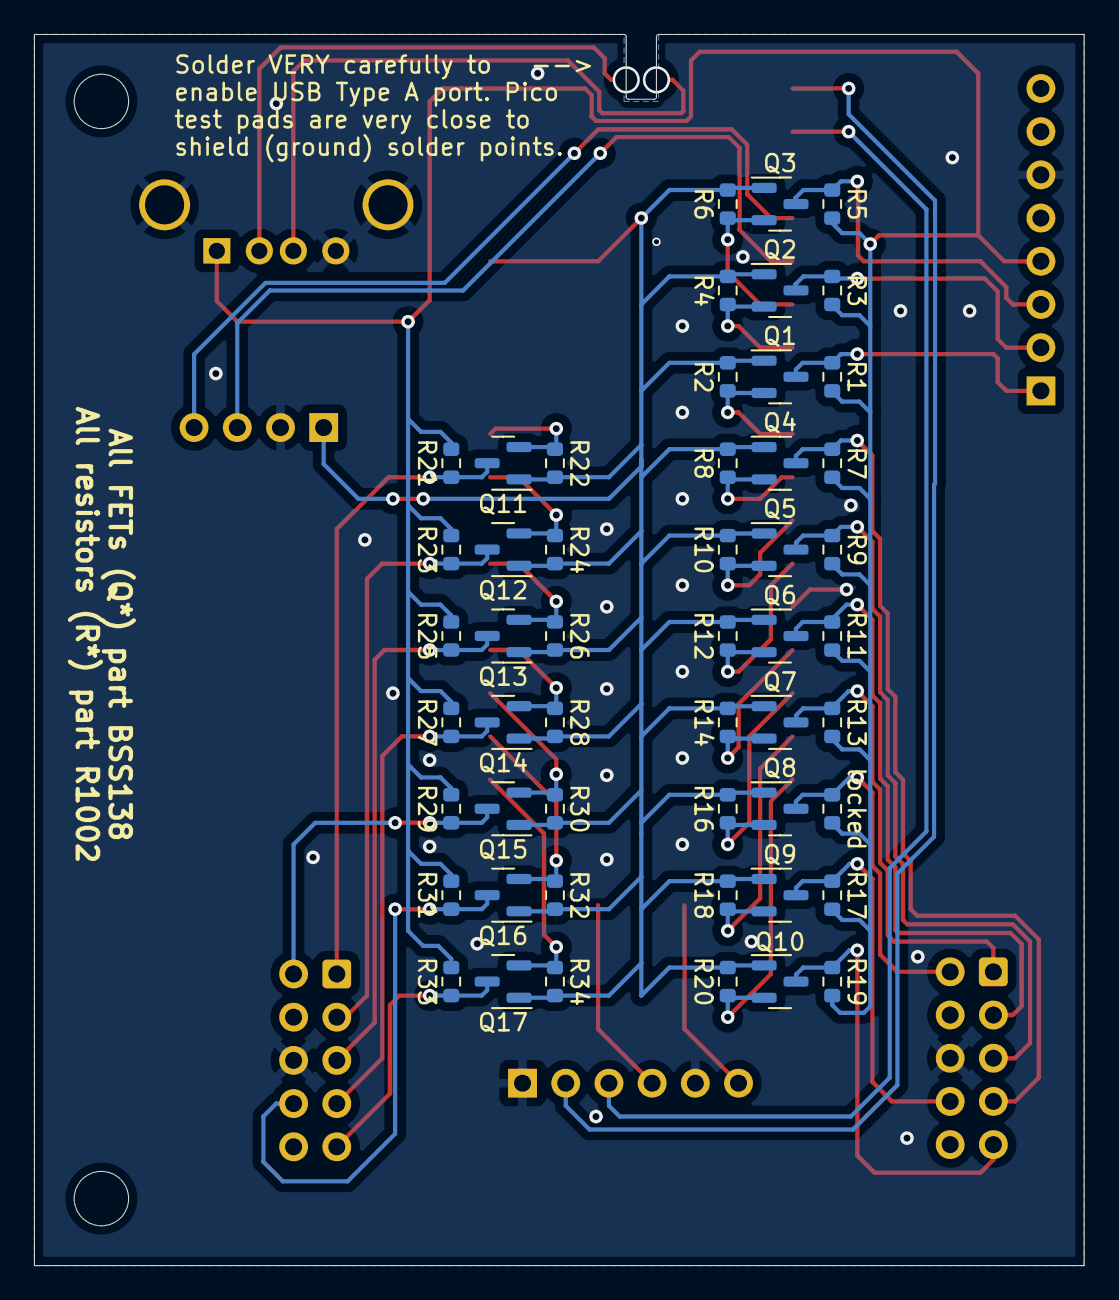
[picture p20: board amigahid-pico.kicad_pcb from below]

Board: 2 copper layers, 61.7 x 72.4 mm, 60 parts (51 on the bottom side), 43 nets.

Other parts of the board:
REF01, REF02: MountingHole_3.2mm_M3
locked: R1002; R_0603_1608Metric

Their connections:
+5V: locked.2; also elsewhere on the board
/cont1 b1: locked.1; also elsewhere on the board
