Klaus-Kupferschmid/amigahid-pico/(commit log)

2026-04-29 Add local development environment for RP2350/Pico2 debugging
    - VSCode launch configs for probe-rs debugger
    - Build scripts (release + debug) for Windows/MSVC
    - Flash scripts for UF2 and probe-rs
    - Upstream sync scripts for tracking borb/amigahid-pico
    - Documentation for breadboard test setup
    - Copilot instructions for project context
2026-05-02 1. vollständiger schematic entwurf
    [Amiga-HID_rev1.0.kicad_sch, RP2350_QFN60.step, mcu.kicad_sch, power.kicad_sch]
2026-05-02 One Top-Level Schematic
    [Amiga-HID_rev1.0.kicad_sch, mcu.kicad_sch, power.kicad_sch]
2026-05-02 Footprints sind vollständig
    [Amiga-HID_rev1.0.kicad_pcb, Amiga-HID_rev1.0.kicad_sch, _bom.csv]
2026-05-03 korrekte USB-A Buchse
    [Amiga-HID_rev1.0.kicad_pcb, Amiga-HID_rev1.0.kicad_sch]
2026-05-03 alle 3d modelle implementiert
    [Amiga-HID_rev1.0.kicad_pcb, Amiga-HID_rev1.0.kicad_sch, _bom.csv]
2026-05-04 pico referenz design
    [RP2350_60QFN_minimal.kicad_pcb, RP2350_60QFN_minimal.kicad_sch, RP2350_QFN60.step]
2026-05-04 aufteilung Bauteile Vorder und Rückseite
    [Amiga-HID_rev1.0.kicad_pcb, Amiga-HID_rev1.0.kicad_sch, _bom.csv]
2026-05-04 Wiederstände überarbeitet
    [Amiga-HID_rev1.0.kicad_pcb, Amiga-HID_rev1.0.kicad_sch, _bom.csv]
2026-05-04 bom überarbeitet
    [_bom.csv]
2026-05-06 Anordnung der Bauteile abgeschlossen
    [Amiga-HID_rev1.0.kicad_pcb, Amiga-HID_rev1.0.kicad_sch, RP2350_60QFN_minimal.kicad_pcb, RP2350_60QFN_minimal.kicad_sch, RP2350_QFN60.step, _bom.csv, amigahid-pico.kicad_pcb, amigahid-pico.kicad_sch]
2026-05-08 fast fertig mit routing
    [Amiga-HID_rev1.0.kicad_pcb, Amiga-HID_rev1.0.kicad_sch]
2026-05-08 J6 war spiegelverkehrt
    [Amiga-HID_rev1.0.kicad_pcb, Amiga-HID_rev1.0.kicad_sch]
2026-05-11 layou Fehler behoben
    [_bom.csv, bom-JLCPCB Assembly Order.xls, bom.csv, designators.csv, positions.csv]
2026-05-13 BOm aktualisiert
    [Amiga-HID_rev1.0.kicad_pcb, Amiga-HID_rev1.0.kicad_sch, RP2350_60QFN_minimal.kicad_pcb, RP2350_60QFN_minimal.kicad_sch, _bom-JLCPCB Assembly Order.xls, _bom.csv, bom .csv, bom-JLCPCB Assembly Order.xls]
2026-05-13 nicht bestückte Komponenten entfernt aus 3d-Ansicht
    [Amiga-HID_rev1.0.kicad_pcb, Amiga-HID_rev1.0.kicad_sch, _bom-JLCPCB Assembly Order.xls, bom .csv, bom.csv]
2026-06-02 test led Code erstellt Software erfolgreich getestet
    [Amiga-HID_rev1.0.kicad_pcb, Amiga-HID_rev1.0.kicad_sch, Amiga-HID_rev1.1.kicad_pcb, Amiga-HID_rev1.1.kicad_sch, Amiga-HID_rev1.1.step, C1046_Sunlord_L_0805_2u2.step, C139797_TactSwitch_4x3.step, C160403_JST_SH_SM03B-SRSS-TB.step]
2026-07-02 Mark REV 1.1 ready to manufacture
    [Amiga-HID_rev1.0.kicad_pcb, Amiga-HID_rev1.0.kicad_sch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]
2026-07-23 LCtrl + LShift + F10 führt zu einem Reset-in-USB-Bootloader
    [led_status.c, led_status.h, main.c]
2026-07-23 text-height und Textsicknes warungen angepasst 3d Modell verbessert
    [Oberseite.stl, Unterseite.stl]
2026-07-23 settings.json damit die unter repositories nicht mehr angezeigt werden
