Klaus-Kupferschmid/amigahid-pico/(notices)

Notices in the files:
kicad/amigahid-pico/amigahid-pico.kicad_pcb:
hid-pico Amiga r5 ©️2022 nine
